ryood/ArduinoPyunPyun/P1050259.jpg

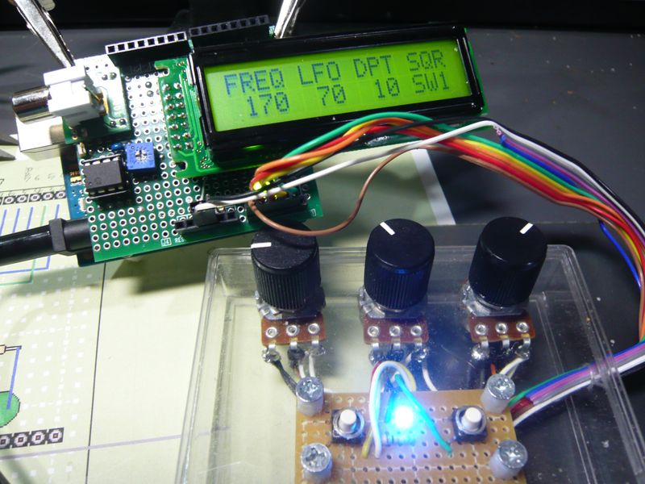
P1050259.jpg
