ryood/ArduinoPyunPyun/README.md

ArduinoPyunPyun
===============
Arduino Uno で作成したピュンピュンマシン
