ryood/ArduinoPyunPyun/(list of files, cad)

Other CAD files:
PyunPyunControler-a-10.dwg
PyunPyunControler-10.dwg
