ryood/ArduinoPyunPyun/Eagle/Arduino PyunPyun.Sch

## EAGLE design Eagle/Arduino PyunPyun.Sch (2014-08-23)

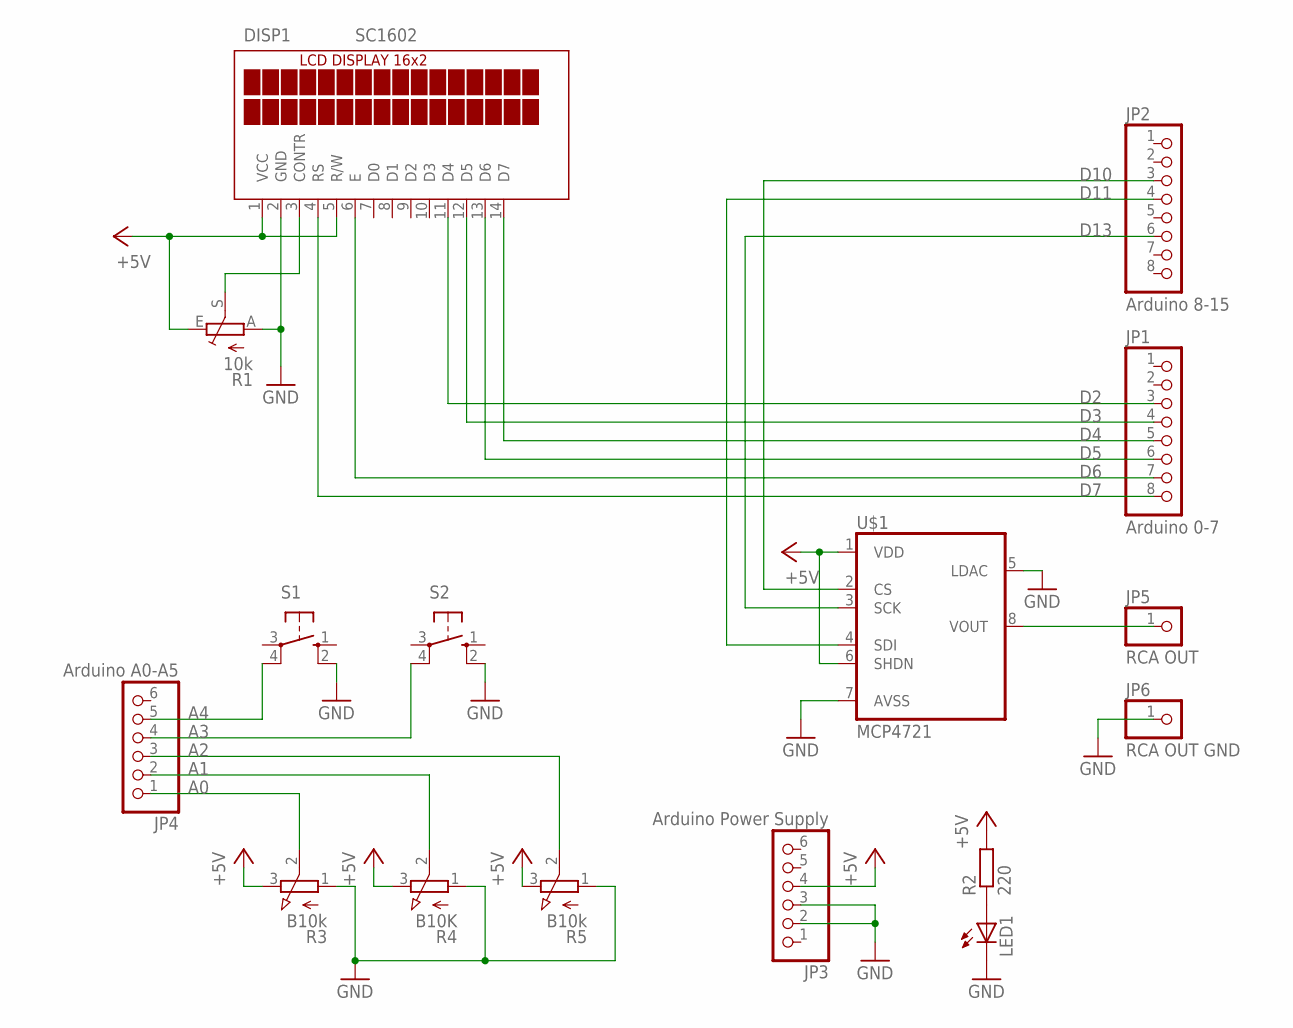
[picture p2: schematic Arduino PyunPyun.Sch]

Parts:
DISP1: SC1602
JP1: Arduino 0-7; 1X08
JP2: Arduino 8-15; 1X08
JP3: Arduino Power Supply; 1X06
JP4: Arduino A0-A5; 1X06
JP5: RCA OUT; 1X01
JP6: RCA OUT GND; 1X01
LED1: LED5MM
R1: 10k; B25P
R2: 220; 0207/7
R3, R5: B10k; 3RP/1610N
R4: B10K; 3RP/1610N
S1, S2: 40-XX; B3F-40XX
U$1: MCP4721

Connections:
+5V: DISP1.1 (VCC), DISP1.5 (R/W), JP3.4, R1.E, R2.2, R3.3 (E), R4.3 (E), R5.3 (E), U$1.1 (VDD), U$1.6 (SHDN)
A0: JP4.1, R3.2 (S)
A1: JP4.2, R4.2 (S)
A2: JP4.3, R5.2 (S)
A3: JP4.4, S2.4 (P1)
A4: JP4.5, S1.4 (P1)
D2: DISP1.11 (D4), JP1.3
D3: DISP1.12 (D5), JP1.4
D4: DISP1.14 (D7), JP1.5
D5: DISP1.13 (D6), JP1.6
D6: DISP1.6 (E), JP1.7
D7: DISP1.4 (RS), JP1.8
D10: JP2.3, U$1.2 (CS)
D11: JP2.4, U$1.4 (SDI)
D13: JP2.6, U$1.3 (SCK)
GND: DISP1.2 (GND), JP3.2, JP3.3, JP6.1, LED1.K (C), R1.A, R3.1 (A), R4.1 (A), R5.1 (A), S1.2 (S1), S2.2 (S1), U$1.5 (LDAC), U$1.7 (AVSS)
unnamed: LED1.A, R2.1
unnamed: JP5.1, U$1.8 (VOUT)
unnamed: DISP1.3 (CONTR), R1.S
