ryood/ArduinoPyunPyun/TestChart.xlsx

Point1 | Point2 | Check | 2014/8/24#1
Arduino 10 | U1 Pin2 | con | ok
Arduino 11 | U1 Pin4 | con | ok
Arduino 13 | U1 Pin3 | con | ok
Arduino 2 | LCD 11 | con | ok
Arduino 3 | LCD 12 | con | ok
Arduino 4 | LCD 14 | con | ok
Arduino 5 | LCD 13 | con | ok
Arduino 6 | LCD 6 | con | ok
Arduino 7 | LCD 4 | con | ok
LCD 1 | 5V | con | ok
LCD 2 | GND | con | ok
LCD 3 | GND | 0～10kΩ | ok
LCD 5 | GND | con | ok
U1 Pin1 | 5V | con | ok
U1 Pin5 | GND | con | ok
U1 Pin6 | 5V | con | ok
U1 Pin7 | GND | con | ok
U1 Pin8 | JP5 | con | ok
JP6 | GND | con | ok
Arduino GND | GND | con | ok
Arduino GND | GND | con | ok
