ryood/ArduinoPyunPyun/Arduino/PyunPyunNo2/WaveTable.h

/******************************************************
  Arduino Pyun Pyun Machine Rev.2
 
  Define waveTable
 
********************************************************/

#include <avr/pgmspace.h>

// table of 1024 values / one period / stored in flash memory
const PROGMEM uint16_t waveTableSine[]  = {
	2047,
	2060,
	2072,
	2085,
	2097,
	2110,
	2122,
	2135,
	2147,
	2160,
	2173,
	2185,
	2198,
	2210,
	2223,
	2235,
	2248,
	2260,
	2273,
	2285,
	2298,
	2310,
	2323,
	2335,
	2347,
	2360,
	2372,
	2385,
	2397,
	2409,
	2422,
	2434,
	2446,
	2459,
	2471,
	2483,
	2496,
	2508,
	2520,
	2532,
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
};
const PROGMEM uint16_t waveTableTriangle[]  = {
	2048,
	2056,
	2064,
	2072,
	2080,
	2088,
	2096,
	2104,
	2112,
	2120,
	2128,
	2136,
	2144,
	2152,
	2160,
	2168,
	2176,
	2184,
	2192,
	2200,
	2208,
	2216,
	2224,
	2232,
	2240,
	2248,
	2256,
	2264,
	2272,
	2280,
	2288,
	2296,
	2304,
	2312,
	2320,
	2328,
	2336,
	2344,
	2352,
	2360,
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
};
const PROGMEM uint16_t waveTableSqure[]  = {
	4095,
	4095,
	4095,
	4095,
	4095,
	4095,
	4095,
	4095,
	4095,
	4095,
	4095,
	4095,
	4095,
	4095,
	4095,
	4095,
	4095,
	4095,
	4095,
	4095,
	4095,
	4095,
	4095,
	4095,
	4095,
	4095,
	4095,
	4095,
	4095,
	4095,
	4095,
	4095,
	4095,
	4095,
	4095,
	4095,
	4095,
	4095,
	4095,
	4095,
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
};

const PROGMEM uint16_t waveTableSawtoothUp[]  = {
	0,
	4,
	8,
	12,
	16,
	20,
	24,
	28,
	32,
	36,
	40,
	44,
	48,
	52,
	56,
	60,
	64,
	68,
	72,
	76,
	80,
	84,
	88,
	92,
	96,
	100,
	104,
	108,
	112,
	116,
	120,
	124,
	128,
	132,
	136,
	140,
	144,
	148,
	152,
	156,
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
};

const PROGMEM uint16_t waveTableSawtoothDown[]  = {
	4095,
	4091,
	4087,
	4083,
	4079,
	4075,
	4071,
	4067,
	4063,
	4059,
	4055,
	4051,
	4047,
	4043,
	4039,
	4035,
	4031,
	4027,
	4023,
	4019,
	4015,
	4011,
	4007,
	4003,
	3999,
	3995,
	3991,
	3987,
	3983,
	3979,
	3975,
	3971,
	3967,
	3963,
	3959,
	3955,
	3951,
	3947,
	3943,
	3939,
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
};
