ryood/ArduinoPyunPyun/(commit log)

2014-08-23 回路図を追加
    [Arduino PyunPyun.Sch]
2014-08-23 テスト表を追加
    [TestChart.xlsx]
2014-08-28 PyunPyunNo2: Rev.2追加
2014-08-29 音は出た（デバッグ中）
2014-08-31 デバッグ中
2014-08-31 WaveTable.h ヘッダファイルを追加
2014-08-31 lfoValueを正の値に変更（デバッグ中）
2014-08-31 デバッグ途中
2014-08-31 lfoValue: 正負の値で動いた
2014-08-31 コメントを整理
2015-08-01 Arduino 1.6.4に対応
